Maniak003/RadonCrystal/README.md

# RadonCrystal
Fork Radon project: https://github.com/radon-lab/ArDos_with_RADON/
