Maniak003/RadonCrystal/FreeCAD/RadonCase.FCStd

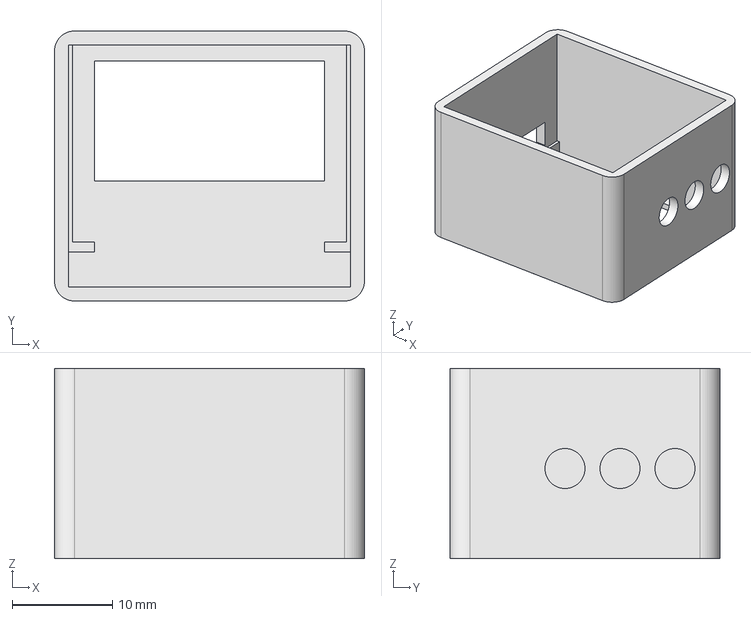
[picture p1: CAD file, 2026-02-08]
FreeCAD/RadonCase.FCStd
31.0 x 27.0 x 19.0 mm
