Maniak003/RadonCrystal/(list of files, cad)

Other CAD files:
FreeCAD/RadonCase.stl
