Maniak003/RadonCrystal/kicad/radon/radon.pdf

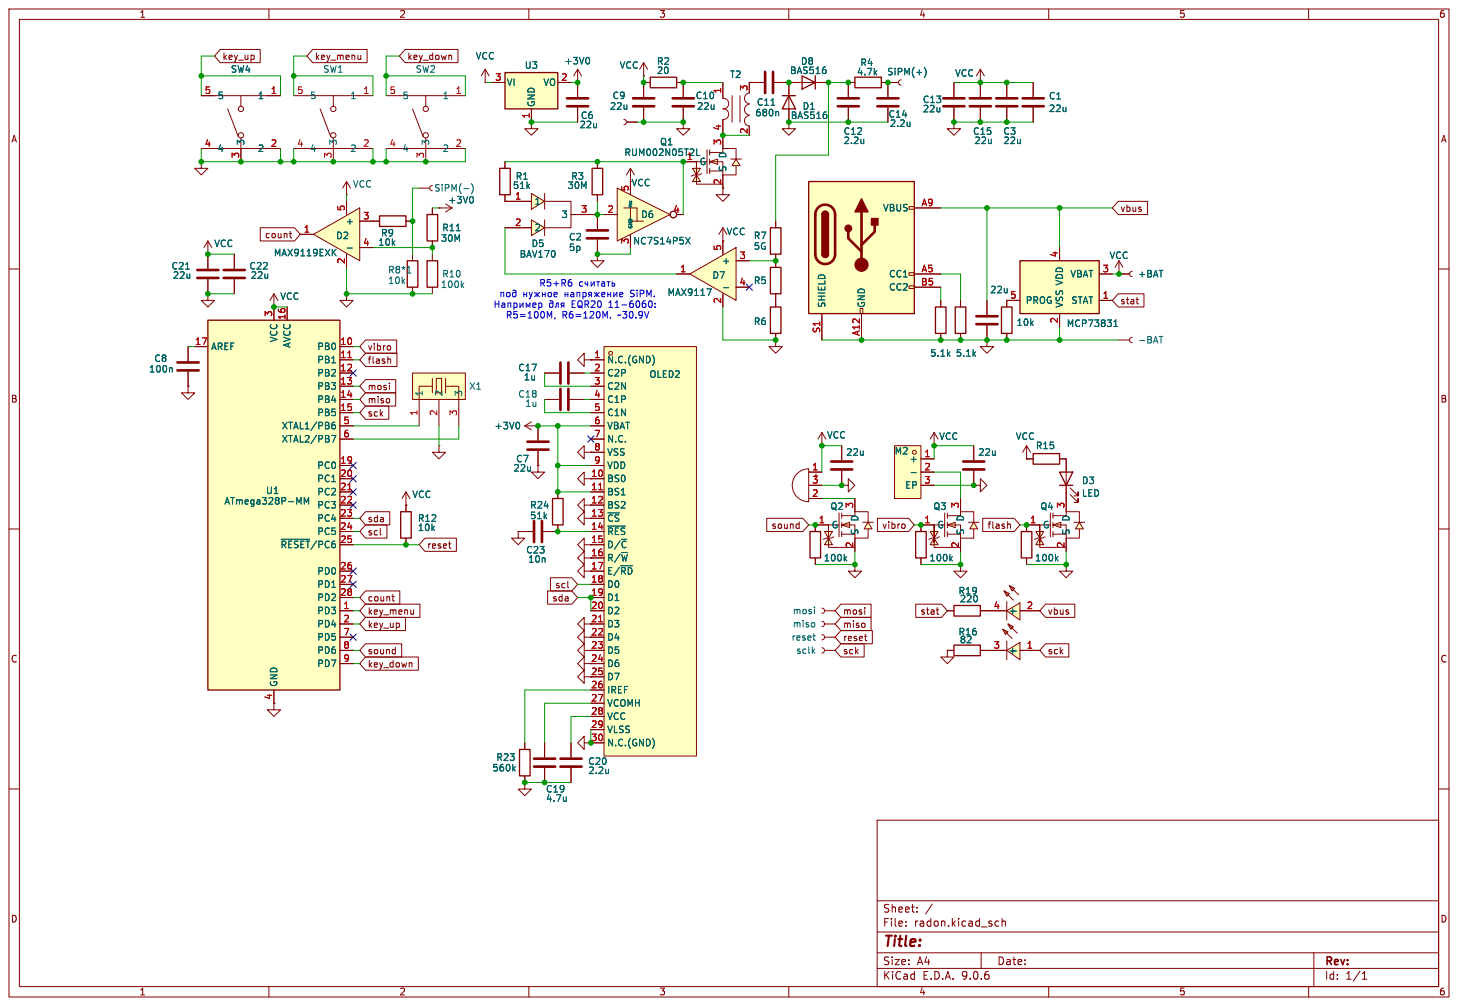
[picture p2: page 1]

IREF 26 VCOMH 27 VCC 28 VLSS 29 N.C.(GND) 30 C23
