Maniak003/RadonCrystal/kicad/radon/radon.kicad_pcb

## KiCad design kicad/radon/radon.kicad_pcb (2026-02-08)

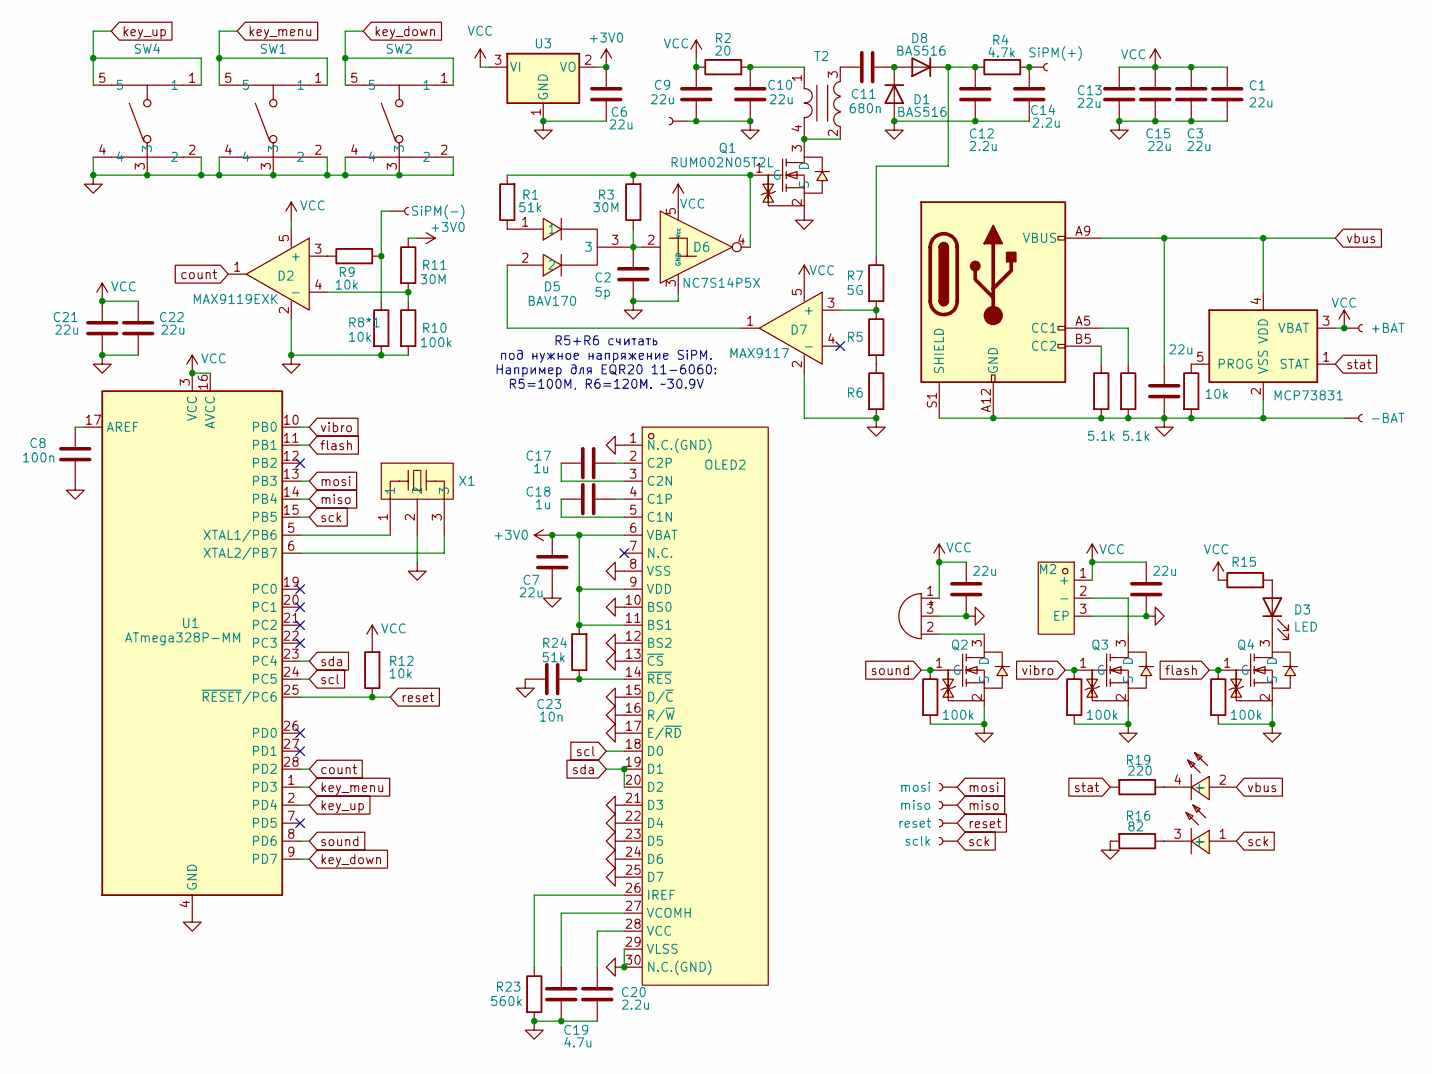
[picture p3: schematic radon.kicad_sch]

Parts:
BZ1: Buzzer; Buzzer55x55
C1, C3, C4, C5, C6, C7, C9, C10, C13, C15, C16, C21, C22: 22u; C_0402_1005Metric
C2: 5p; C_0402_1005Metric
C8: 100n; C_0402_1005Metric
C11: 680n; C_0402_1005Metric
C12, C14: 2.2u; C_0603_1608Metric
C17, C18: 1u; C_0402_1005Metric
C19: 4.7u; C_0402_1005Metric
C20: 2.2u; C_0402_1005Metric
C23: 10n; C_0402_1005Metric
D1, D8: BAS516; D_SOD-523
D2: MAX9119EXK; SOT-353_SC-70-5
D3: LED; D_0805_2012Metric
D5: BAV170; SOT-523; LCSC Part C68970
D6: NC7S14P5X; SC-70-5_L2.1-W1.3-P0.65-LS2.2-BR
D7: MAX9117; SC-70-5_L2.1-W1.3-P0.65-LS2.2-BR
J1: SiPM(+); ConnMini
J2: SiPM(-); ConnMini
J3: USB_C_Receptacle_PowerOnly_6P; USB_C_Receptacle_GCT_USB4135-GF-A_6P_TopMnt_Horizontal
J5: Conn; ConnMini
J7: +BAT; ConnMini
J8: -BAT; ConnMini
J9: mosi; ConnMini
J10: miso; ConnMini
J11: sclk; ConnMini
J12: reset; ConnMini
LED1: LTST-C195KGJRKT; LED-ARRAY-SMD_0603-4P-L1.6-W1.5-BR-RD; LCSC Part C125104
M2: Z3OC1T8219731; VIBRATING-MOTOR-SMD_3P-C9900001680; LCSC Part C2894731
OLED2: N096-2864KSWEG01-H30; OLED_0.96-30P-P0.70-12864; LCSC Part C2890596
Q1, Q2, Q3, Q4: RUM002N05T2L; SOT-723-3_L1.2-W0.8-LS1.20-BR; LCSC Part C510347
R1, R24: 51k; R_0402_1005Metric
R2: 20; R_0402_1005Metric
R3, R11: 30M; R_0402_1005Metric
R4: 4.7k; R_0402_1005Metric
R5: 300k; R_0402_1005Metric
R6: 10M; R_0402_1005Metric
R7: 5G; R_0805_2012Metric
R8*1, R9, R12, R14: 10k; R_0402_1005Metric
R10, R20, R21, R22: 100k; R_0402_1005Metric
R15: 51; R_0402_1005Metric
R16: 82; R_0402_1005Metric
R17, R18: 5.1k; R_0402_1005Metric
R19: 220; R_0402_1005Metric
R23: 560k; R_0402_1005Metric
SW1, SW2, SW4: KMS231GLFS; SW-SMD_KMS2XXGXXX; LCSC Part C221701
T2: ATB322515-0110-T000; XFMR-SMD_ATB322515-0110-T000; LCSC Part C415291
U1: ATmega328P-MM; QFN-28-1EP_4x4mm_P0.45mm_EP2.4x2.4mm
U2: MCP73831; SOT-23-5
U3: MCP1700x-300xxTT; SOT-23
X1: CSTCE16M0V53-R0; Resonator_SMD_Murata_CSTxExxV-3Pin_3.0x1.1mm; LCSC Part C32180

Connections:
+3V0: C6.1, C7.1, OLED2.6 (VBAT), OLED2.9 (VDD), OLED2.11 (BS1), R11.1, R24.2, U3.2 (VO)
GND: BZ1.3 (GND), C1.2, C2.1, C3.1, C4.2, C5.2, C6.2, C7.2, C8.2, C9.2, C10.2, C12.1, C13.1, C14.1, C15.1, C16.2, C19.2, C20.2, C21.2, C22.2, C23.1, D1.2 (A), D2.2, D6.3 (GND), D7.2, J3.A12 (GND), J3.B12 (GND), J3.S1 (SHIELD), J5.1, J8.1, M2.3 (EP), OLED2.1 (N.C.(GND)), OLED2.8 (VSS), OLED2.10 (BS0), OLED2.12 (BS2), OLED2.13 (~CS), OLED2.15 (D/~C), OLED2.16 (R/~W), OLED2.17 (E/~RD), OLED2.21 (D3), OLED2.22 (D4), OLED2.23 (D5), OLED2.24 (D6), OLED2.25 (D7), OLED2.29 (VLSS), OLED2.30 (N.C.(GND)), Q1.2 (S), Q2.2 (S), Q3.2 (S), Q4.2 (S), R6.2, R8*1.2, R10.2, R14.2, R16.2, R17.2, R18.2, R20.2, R21.2, R22.2, R23.2, SW1.2, SW1.3, SW1.4, SW2.2, SW2.3, SW2.4, SW4.2, SW4.3, SW4.4, U1.4 (GND), U1.18 (GND), U1.29 (GND), U2.2 (VSS), U3.1 (GND), X1.2
unnamed: BZ1.2 (+), Q2.3 (D)
unnamed: C2.2, D5.3, D6.2, R3.1
unnamed: C10.1, R2.2, T2.1
unnamed: C11.1, T2.3
unnamed: C14.2, J1.1, R4.2
unnamed: C11.2, D1.1 (K), D8.2 (A)
unnamed: D2.3 (+), R9.1
unnamed: D2.4 (-), R10.1, R11.2
unnamed: D3.2 (A), R15.2
unnamed: D3.1 (K), Q4.3 (D)
unnamed: D5.1, R1.1
unnamed: D5.2, D7.1
unnamed: D7.3 (+), R5.1, R7.2
unnamed: C12.2, D8.1 (K), R4.1, R7.1
unnamed: J2.1, R8*1.1, R9.2
unnamed: J3.A5 (CC1), R17.1
unnamed: J3.B5 (CC2), R18.1
unnamed: LED1.3 (-), R16.1
unnamed: LED1.4 (-), R19.1
unnamed: M2.2 (-), Q3.3 (D)
unnamed: C18.2, OLED2.5 (C1N)
unnamed: C18.1, OLED2.4 (C1P)
unnamed: C17.2, OLED2.3 (C2N)
unnamed: C17.1, OLED2.2 (C2P)
unnamed: OLED2.26 (IREF), R23.1
unnamed: C20.1, OLED2.28 (VCC)
unnamed: C19.1, OLED2.27 (VCOMH)
unnamed: C23.2, OLED2.14 (~RES), R24.1
unnamed: Q1.3 (D), T2.2, T2.4
unnamed: D6.4, Q1.1 (G), R1.2, R3.2
unnamed: R5.2, R6.1
unnamed: C8.1, U1.17 (AREF)
unnamed: U1.5 (XTAL1/PB6), X1.1
unnamed: U1.6 (XTAL2/PB7), X1.3
unnamed: R14.1, U2.5 (PROG)
VCC: BZ1.1 (-), C1.1, C3.2, C4.1, C5.1, C9.1, C13.2, C15.2, C21.1, C22.1, D2.5, D6.5 (Vcc), D7.5, J7.1, M2.1 (+), R2.1, R12.2, R15.1, U1.3 (VCC), U1.16 (AVCC), U2.3 (VBAT), U3.3 (VI)
count: D2.1, U1.28 (PD2)
flash: Q4.1 (G), R22.1, U1.11 (PB1)
key_down: SW2.1, SW2.5, U1.9 (PD7)
key_menu: SW1.1, SW1.5, U1.1 (PD3)
key_up: SW4.1, SW4.5, U1.2 (PD4)
miso: J10.1, U1.14 (PB4)
mosi: J9.1, U1.13 (PB3)
reset: J12.1, R12.1, U1.25 (~RESET/PC6)
sck: J11.1, LED1.1 (+), U1.15 (PB5)
scl: OLED2.18 (D0), U1.24 (PC5)
sda: OLED2.19 (D1), OLED2.20 (D2), U1.23 (PC4)
sound: Q2.1 (G), R20.1, U1.8 (PD6)
stat: R19.2, U2.1 (STAT)
vbus: C16.1, J3.A9 (VBUS), J3.B9 (VBUS), LED1.2 (+), U2.4 (VDD)
vibro: Q3.1 (G), R21.1, U1.10 (PB0)

Notes on the sheet:
R5+R6 считать под нужное напряжение SiPM. Например для EQR20 11-6060: R5=100M, R6=120M. ~30.9V

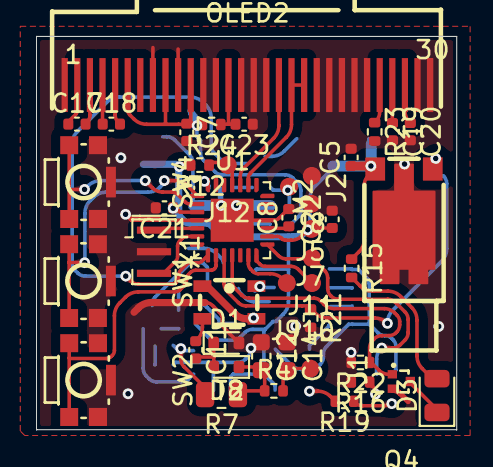
[picture p4: board radon.kicad_pcb from above]

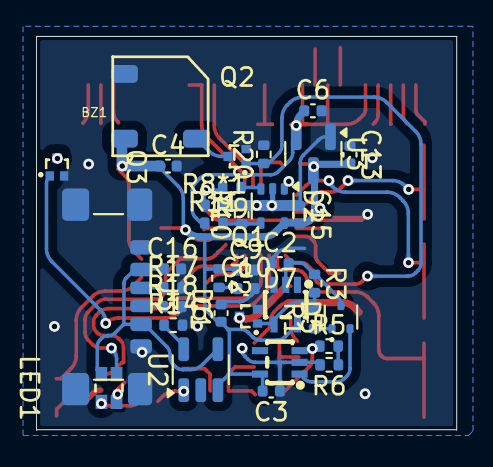
[picture p5: board radon.kicad_pcb from below]

Board: 2 copper layers, 23.3 x 21.9 mm, 79 parts (35 on the bottom side), 53 nets.
