Maniak003/RadonCrystal/Arduino/ArDos_with_RADON/config.h

#define RUSSIAN //для смены языка необходимо указать один из вариантов (по умолчанию доступны - RUSSIAN(русский) и ENGLISH(английский), либо добавить свои метаданные в файл "languages")
#define RADON //для смены логотипа устройства необходимо указать один из вариантов(RADON или ARDOS)
#define SSD1306 //выбор типа поключенного дисплея (доступны - PCD8544(NOKIA5110), SSD1306(OLED128x64), SH1106(OLED132x64) и CH1116(OLED128x64))
#define USE_UART       0     //использовать UART для передачи данных (0 - выключить вывод данных | 1 - включить вывод данных)
#define UART_BAUND     115200 //скорость UART для передачи данных (9600 | 19200 | 38400 | 57600 | 74880 | 115200)
#define UART_SEND_BACK 1     //отправлять фон в мкр/ч (0 - выключить вывод фона | 1 - включить вывод фона)
#define UART_SEND_DOSE 0     //отправлять дозу в мкр (0 - выключить вывод дозы | 1 - включить вывод дозы)
#define UART_SEND_IMP  0     //отправлять количество имп/с (0 - выключить вывод имп/с | 1 - включить вывод имп/с)
#define PUMP_READ_MEM       0    //считывать предыдущие настройки преобразователя из памяти при отключеной отладке (0 - настройки из памяти игнорируются, считываются только указанные при прошивке | 1 - настройки считываются из памяти, указанные при прошивке игнорируются)
#define DEFAULT_ADC_VALUE   185  //значение АЦП при котором 400В с учетом вашего делителя напряжения (только для обратной связь на АЦП)(0..255)(для значений делителя с сайта srukami - 163 | alexadresat - 185)
#define DEFAULT_DIV_FACTOR  500  //коеффициент делителя напряжения, зависит от вашего делителя (только для обратной связь на АЦП)(10..1500)(для значений делителя с сайта srukami k_delitel - 576 | alexadresat - 500)
#define DEFAULT_INDUCTION   330  //индукция для расчета длинны импульса высоковольтного трансформатора (40..700)(шаг 10)
#define DEFAULT_REFERENCE   1.10 //опорное напряжение (0.5..1.5)(v)
#define DEFAULT_GEIGER_TIME 1.0 //время измерения (для СБМ-20 - 36 секунд)(2.0..99.9, 100..150)(s)
#define DISP_SCALE_IMG      1 //увеличить масштаб изображения дисплея(только для SSD1306 и SH1106) (0 - стандартный масштаб 84x48 | 1 - увеличенный масштаб 126x60)
#define DISP_BACKL_INV      0 //инвертирование управления подсветкой дисплея(только для PCD8544) (0 - низкий уровень включает подсветку | 1 - высокий уровень включает подсветку)
#define DISP_POWER_INV      0 //инвертирование управления питанием дисплея (0 - низкий уровень включает дисплей | 1 - высокий уровень включает дисплей)
#define BUTTON_MODE         0 //тип управления устройством(0 - кнопки | 1 - джойстик)
#define APPROX_BACK_SCORE   1 //аппроксимированный счет фона (1 - аппроксимированный счет | 0 - линейный счет фона)
#define GEIGER_DEAD_TIME    1 //учет мертвого времени счетчика (1 - мертвое время счетчика учитывается | 0 - мертвое время счетчика не учитывается)
#define GEIGER_OWN_BACK     1 //учет собственного фона счетчика (1 - собственный фон счетчика учитывается | 0 - собственный фон счетчика не учитывается)
#define TYPE_GRAF_MOVE      1 //выбор направления движения графика (0 - справа<-налево | 1 - слева->направо)
#define TYPE_ALARM_IND      1 //выбор типа индикации при тревоге (0 - только вибрация | 1 - вибрация и мигание фонариком | 2 - вибрация и мигание подсветкой)
#define TYPE_MEASUR_LOGBOOK 0 //тип данных записываемых в журнал замеров бета (0 - мкР/ч | 1 - ч/см2)
#define ALARM_AUTO_DISABLE  1 //автоматическое отключение тревоги (0 - отключать только по нажатию клавиши | 1 - отключать по нажатию клавиши или спаду фона/тайм-ауту)
#define SEARCH_ANIM_DISABLE 0 //отключение анимации шкалы в режиме поиск(позволит поднять производительность) (0 - включить анимацию шкалы | 1 - отключить анимацию шкалы)
#define DEBUG_RETURN        1 //вернуть отладку преобразователя (1 - отладка доступна из интерфеса | 0 - отладка не доступна из интерфейса)
#define LOGBOOK_RETURN      1 //вернуть журнал всех данных (1 - доступен полный журнал(тревога/предупреждения/замеры/ошибки) | 0 - доступен только журнал замеров)
#define PWR_ON_RETURN       1 //вернуть включение питания по удержанию клавиши (1 - включение по удержанию разрешено | 0 - включение по удержанию запрещено)
#define BUFF_SCALE_RETURN   0 //вернуть шкалы заполнености буфера (1 - шкалы заполнености буфера | 0 - шкала предела фона)
#define ROTATE_DISP_RETURN  0 //вернуть разворот дисплея в настройки (1 - разворот дисплея доступен из настроек | 0 - разворот дисплея не доступен из настроек)
#define MIN_GEIGER_TIME   0.1    //минимальное время счета (0.1..10)(s)
#define MAX_GEIGER_TIME   150    //максимальное время счета (10..500)(s)
#define OWN_BACK          5.0   //собственный фон счетчика(0.2имп/с для СБМ-20)(0.1..1)(imp/s)
#define DEAD_TIME         0.001  //мертвое время счетчика(200мкрС для СБМ-20)(0.0001..0.0002)(us/1000000)
#define COUNT_RATE        500    //минимальная скорость счета для начала корректировки мертвого времени(50..500)(imp/s)
#define GEIGER_AREA       8      //площадь датчика для вычичления ч-ц/см2*мин(8см2 для СБМ-20)(1.0..50.0)(см2)
#define STAT_UPD_TIME     60     //интервал записи статистики в память(10..3600)(s)
#define TYPE_CHAR_FILL    43     //выбор симола заполнителя на главных экранах(48 - "0" | 47 - "/" | 46 - "." | 45 - "-" | 44 - "_" | 43 - " ")
#define DEFAULT_TIME_SLEEP     10  //время до ухода в сон(должно быть больше чем время подсветки) (10..250)(s)
#define DEFAULT_TIME_BRIGHT    5   //время до отключения подсветки (5..250)(s)
#define DEFAULT_CONTRAST       50  //контрастность дисплея PCD8544 (0..127) или яркость дисплея SSD1306 (50..250)(шаг 10)
#define DEFAULT_ROTATION       0   //разворот дисплея (0 - перевернуть на 0° | 1 - перевернуть на 180°)
#define DEFAULT_SLEEP_MODE     0   //режим сна (0 - сон выкл | 1 - только подсветка | 2 - сон вкл)
#define DEFAULT_RAD_FLASH      1   //индикация попадания частиц (0 - выкл | 1 - вкл)
#define DEFAULT_BUZ_SWITCH     0   //тип треска пищалкой (0 - выкл | 1 - вкл | 2 - фон1)
#define DEFAULT_KNOCK_DISABLE  0   //запрет треска кнопками (1 - вкл | 0 - выкл)
#define DEFAULT_VOLUME         10  //громкость всех звуков (1..10)
#define DEFAULT_SENSITIV       5   //чувствительность к изменению фона(3..13)
#define DEFAULT_SIGMA_LVL      3   //уровень сигмы (0 - 1 сигма | 1 - 2 сигмы | 2 - 3 сигмы)
#define DEFAULT_RAD_MODE       0   //единицы измерения дозы/фона (0 - мкР | 1 - мкЗв)
#define DEFAULT_AVERAG         10  //длинна буфера усреднения замеров фона (1..60)(0 - выкл)
#define DEFAULT_MEASUR_POS     0   //указатель на время разностного замера в массиве (0..9)
#define DEFAULT_SEARCH_BUF     3   //указатель на количество ячеек буфера в массиве режима "поиск" из которых рассчитываются единицы измерения(0..8)(8 - авто)
#define DEFAULT_SEARCH_POS     3   //указатель на время обновления графика в массиве (0..7)
#define DEFAULT_ALARM_BACK     0   //режим тревоги фона (0 - выкл | 1 - звук | 2 - вибрация | 3 - звук+вибрация)
#define DEFAULT_LEVEL_BACK_1   30  //уровень тревоги 1 фона (30..300)
#define DEFAULT_LEVEL_BACK_2   300 //уровень тревоги 2 фона (300..65500)
#define DEFAULT_ALARM_DOSE     0   //режим тревоги дозы (0 - выкл | 1 - звук | 2 - вибрация | 3 - звук+вибрация)
#define DEFAULT_LEVEL_DOSE_1   10  //уровень тревоги 1 дозы (10..300)
#define DEFAULT_LEVEL_DOSE_2   300 //уровень тревоги 2 дозы (300..65500)
#define DEFAULT_LOGBOOK_ALARM  1   //разрешить запись тревоги в журнал (0 - выкл | 1 - вкл)
#define DEFAULT_LOGBOOK_WARN   1   //разрешить запись предупреждений в журнал (0 - выкл | 1 - вкл)
#define DEFAULT_LOGBOOK_MEASUR 1   //разрешить запись замеров бета в журнал (0 - выкл | 1 - вкл)
#define SEARCH_IND_MAX      200 //максимум предела шкалы имп/с режима "Поиск"(48..10000)(имп/с)
#define ALARM_AUTO_GIST     3   //гистерезис(разница) автоматического отключения тревоги(1..99)(%)
#define MIN_IMP_SEARCH_BUFF 3   //минимальное количество импульсов для максимума графика режима "Поиск"(2..23)(имп)
#define MIN_IMP_MAIN_BUFF   3   //минимальное количество импульсов для максимума графика секундных замеров(2..15)(имп)
#define MIN_IMP_MID_BUFF    30  //минимальное количество импульсов для максимума графика минутных замеров(15..120)(имп)
#define START_TIME          1000 //длительность ожидания перед стартом прошивки(50..10000)(ms)
#define LOAD_TIME           200  //длительность ожидания загрузки данных при первом включении(50..10000)(ms)
#define FONT_TIME           2000 //длительность ожидания заставки при первом включении(50..10000)(ms)
#define POWER_TIME          2000 //длительность ожидания отображениия разряженой акб при включении(50..10000)(ms)
#define POWER_ON_TIME       2000 //длительность удержания кнопки включения(50..10000)(ms)
#define MASSEGE_TIME        1000 //длительность отображения окон(50..10000)(ms)
#define ERROR_MASSEGE_TIME  3000 //длительность отображения окна ошибок(1000..10000)(ms)
#define TIME_OUT_SETTINGS   15   //тайм-аут автоматического выхода из настроек(0 - выкл)(5..250)(s)
#define TIME_OUT_MENU       15   //тайм-аут автоматического выхода из меню(0 - выкл)(5..250)(s)
#define TIME_OUT_INFO       15   //тайм-аут автоматического выхода из информации об устройстве(0 - выкл)(5..250)(s)
#define TIME_OUT_DATA       15   //тайм-аут автоматического выхода из диалога выбора(0 - выкл)(5..250)(s)
#define TIME_OUT_PARAM      30   //тайм-аут автоматического выхода из параметров(0 - выкл)(5..250)(s)
#define TIME_OUT_DEBUG      30   //тайм-аут автоматического выхода из отладки(0 - выкл)(5..250)(s)
#define TIME_OUT_LOGBOOK    30   //тайм-аут автоматического выхода из журнала(0 - выкл)(5..250)(s)
#define TIME_OUT_ALARM      30   //тайм-аут автоматического отключения тревоги(0 - выкл)(5..250)(s)
#define CONV_ERROR_TIME     10   //время после которого можно ститать что преобразователь перегружен(10..50)(s)
#define DET_ERROR_TIME      5    //время после которого можно ститать что счетчик в коротком замыкании(5..10)(s)
#define IMP_ERROR_TIME      60   //время после которого можно ститать что импульсы от счетчика отсутствуют(10..240)(s)
#define UPD_BAT_TIME        60   //частота обновлния информации о заряде батареи(1..255)(s)
#define LOW_BAT_TIME        30   //частота появления сообщения о разряде батареи(1..255)(s)
#define LOW_BAT_POWER_V     3.0  //при каком значение АЦП считать акб разряженной и не давать устройству включиться(0..5.0)(v)
#define LOW_BAT_STAT_V      3.2  //при каком значение АЦП считать акб разряженной(0..5.0)(v)
#define MIN_BAT_V           3.2  //значение АЦП при разряженной батарее(0..5.0)(v)
#define MAX_BAT_V           4.2  //значение АЦП при заряженной батарее(0..5.0)(v)
#define IMP_PWR_MANAGER     100  //порог отключения режима энергосбережения для более корректной работы устройства(100..1000)(imp/s)
#define IMP_PWR_DOWN        5    //порог отключения режима глубокого энергосбережения для более корректной работы устройства(0..100)(imp/s)
#define IMP_PWR_GIST        30   //гистерезис(разница) включения энергосбережения(1..99)(%)
#define RAD_SLEEP_OUT       100  //порог выхода из сна при высоких уровнях фона(100..10000)(uRh)
#define RAD_ACCUR_WARN      70   //порог начала работа тревоги фона в зависимости от набранной точности(1..99)(%)
#define RAD_ACCUR_START     70   //порог начала фиксирования максимального уровня фона в зависимости от набранной точности(1..99)(%)
#define DEF_WDT_PERIOD      1750 //период wdt по умолчанию(1600..1800)(us/10)
#define MAX_WDT_PERIOD      2500 //максимальный wdt период(1750..1850)(us/10)
#define MIN_WDT_PERIOD      1500 //минимальный wdt период(1650..1750)(us/10)
#define BTN_GIST_TICK       2    //время для защиты от дребезга(0..255)(1ед. -> +-16мс)
#define BTN_HOLD_TICK       30   //время после которого считается что кнопка зажата(0..255)(1ед. -> +-16мс)
#define BTN_KEEP_TICK       7    //частота с которой возвращаются клики если кнопка зажата(0..255)(1ед. -> +-16мс)
#define RESET_BUFF_NUM    5   //количество ячеек буфера сброса замера фона(2..60)(сек)
#define RESET_BUFF_TIME   2   //количество секунд которые останутся в буфере после сброса(2..60)(сек)
#define DEBUG_ENABLE      0   //выводить отладку коэффициента(0 - не выводить | 1 - выводить)
#define REBOOT_TICK       255 //количество циклов до аварийной перезагрузки(5..255)(1ед. -> +-16мс)
const uint8_t diff_measuring[10] PROGMEM = {1, 2, 3, 5, 7, 10, 20, 30, 40, 60}; //массив времени разностных замеров(1..99)(m)(не более 10 пресетов)
const uint8_t search_score[8] PROGMEM = {2, 4, 6, 8, 12, 16, 20, 24}; //количество ячеек буфера режима "поиск" из которых рассчитываются единицы измерения(1..76)(не более 8 пресетов)
const uint16_t search_time[8] PROGMEM = {140, 280, 420, 560, 700, 840, 980, 1120}; //время обновления данных в режиме поиска(140..1120)(ms)(не более 8 пресетов)
#define PATTERNS_SCALE 3 //количество патернов шкалы фона
const uint16_t back_scale[PATTERNS_SCALE][2] PROGMEM = { //массив шкалы фона
  {1, 25}, //паттерн 0 - порог мкЗ/ч(1..1500) | максимум шкалы(1..81)
  {10, 40}, //паттерн 1 - порог мкЗ/ч(1..1500) | максимум шкалы(1..81)
  {1440, 81}, //паттерн 2 - порог мкЗ/ч(1..1500) | максимум шкалы(1..81)
};
#define PATTERNS_APROX  4 //количество патернов аппроксимации счета фона
const uint16_t back_aprox_imp[PATTERNS_APROX] PROGMEM = { //массив порогов импульсов аппроксимации счета фона(imp/s)(50..65000)
  2000, //паттерн 0
  800,  //паттерн 1
  400,  //паттерн 2
  200   //паттерн 3
};
const float back_aprox_coef[PATTERNS_APROX] PROGMEM = { //массив коэффициентов чувствительности аппроксимации счета фона(0.5..1.5)
  0.89, //паттерн 0
  0.90, //паттерн 1
  0.91, //паттерн 2
  1.03  //паттерн 3
};
const uint16_t alarm_vibro[][2] PROGMEM = { //массив семплов вибрации тревоги
  {1, 150}, //семпл 0 - (0 - выкл | 1 - вкл) | длительность(50..1000)(ms)
  {0, 250}, //семпл 1 - (0 - выкл | 1 - вкл) | длительность(50..1000)(ms)
  {1, 150}, //семпл 2 - (0 - выкл | 1 - вкл) | длительность(50..1000)(ms)
  {0, 250}, //семпл 3 - (0 - выкл | 1 - вкл) | длительность(50..1000)(ms)
  {1, 150}, //семпл 4 - (0 - выкл | 1 - вкл) | длительность(50..1000)(ms)
  {0, 550}, //семпл 5 - (0 - выкл | 1 - вкл) | длительность(50..1000)(ms)
};
#define RAD_FLASH_TIME    20 //длительность свечения светодиода при поподании частиц(1..255)(ms)
#define FREQ_BUZZ 250 //частота щелчков(10..10000)(Hz)
#define TIME_BUZZ 10 //длительность щелчков(10..500)(ms)
#define FREQ_BEEP 1000 //частота звука клавиш(10..10000)(Hz)
#define TIME_BEEP 30 //длительность звука клавиш(10..500)(ms)
#define MEASUR_SOUND  1 //звука готовности замера(0 - звук выключен | 1 - звук включен)
#define BAT_LOW_SOUND 1 //звук разряда акб(0 - звук выключен | 1 - звук включен)
const uint16_t measur_sound[][3] PROGMEM = { //массив семплов мелодии замера || {семпл - частота(10..10000)(Hz), | длительность звука(50..1000)(ms), | длительность семпла(50..1500)(ms)}
  {1500, 100, 200}, //семпл 0
  {1500, 100, 200}, //семпл 1
  {1500, 100, 200}  //семпл 2
};
const uint16_t bat_low_sound[][3] PROGMEM = { //массив семплов мелодии замера || {семпл - частота(10..10000)(Hz), | длительность звука(50..1000)(ms), | длительность семпла(50..1500)(ms)}
  {1500, 200, 200}, //семпл 0
  {1000, 200, 200}, //семпл 1
  {500, 200, 200}  //семпл 2
};
const uint16_t error_sound[][3] PROGMEM = { //массив семплов мелодии замера || {семпл - частота(10..10000)(Hz), | длительность звука(50..1000)(ms), | длительность семпла(50..1500)(ms)}
  {1000, 200, 200}, //семпл 0
  {1500, 200, 600}, //семпл 1
  {1000, 200, 200}, //семпл 2
  {1500, 200, 600}, //семпл 3
  {1000, 200, 200}, //семпл 4
  {1500, 200, 600}  //семпл 5
};
const uint16_t warn_sound[][3] PROGMEM = { //массив семплов мелодии замера || {семпл - частота(10..10000)(Hz), | длительность звука(50..1000)(ms), | длительность семпла(50..1500)(ms)}
  {1500, 200, 200}, //семпл 0
  {1000, 200, 200}, //семпл 1
  {1500, 200, 200}, //семпл 2
  {1000, 200, 1000} //семпл 3
};
const uint16_t alarm_sound[][3] PROGMEM = { //массив семплов мелодии замера || {семпл - частота(10..10000)(Hz), | длительность звука(50..1000)(ms), | длительность семпла(50..1500)(ms)}
  {550, 100, 150}, //семпл 0
  {550, 100, 150}, //семпл 1
  {550, 100, 150}, //семпл 2
  {550, 100, 150}, //семпл 3
  {1500, 200, 250}, //семпл 4
  {1500, 200, 250}, //семпл 5
  {550, 100, 150}, //семпл 6
  {550, 100, 150}, //семпл 7
  {550, 100, 550}  //семпл 8
};
#define SOUND_PATTERN(ptr) {(uint16_t)&ptr, sizeof(ptr)} //маска для массива мелодий
const uint16_t general_sound[][2] PROGMEM = {
  SOUND_PATTERN(measur_sound),
  SOUND_PATTERN(bat_low_sound),
  SOUND_PATTERN(error_sound),
  SOUND_PATTERN(warn_sound),
  SOUND_PATTERN(alarm_sound)
};
