Maniak003/RadonCrystal/(commit log)

2026-02-08 новый файл: FreeCAD/RadonCase.FCStd новый файл: FreeCAD/RadonCase.stl новый файл: kicad/radon/fp-info-cache новый файл: kicad/radon/radon.kicad_pcb новый файл: kicad/radon/radon.kicad_prl новый файл: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
    [RadonCase.FCStd, RadonCase.stl, radon.kicad_pcb, radon.kicad_sch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]
2026-02-08 изменено: Arduino/ArDos_with_RADON/connection.h изменено: FreeCAD/RadonCase.FCStd изменено: FreeCAD/RadonCase.stl
    [RadonCase.FCStd, RadonCase.stl]
2026-02-08 изменено: FreeCAD/RadonCase.FCStd изменено: FreeCAD/RadonCase.stl
    [RadonCase.FCStd, RadonCase.stl]
2026-02-08 удалено: FreeCAD/RadonCase.FCStd1
